Jaycar-Electronics/Portable-Digital-Compass/compass/startup_bitmap.h

#ifndef __COMPASS_STARTUP_BMP_H__
#define __COMPASS_STARTUP_BMP_H__

static const unsigned char PROGMEM compass_startup_bmp[] = {
0x00, 0x00, 0x00, 0x00, 0x00, 0x00, 0x00, 0x00, 0x00, 0x00, 0x00, 0x00, 0x00, 0x00, 0x00, 0x00,
0x00, 0x00, 0x00, 0x00, 0x00, 0x00, 0x00, 0x00, 0x07, 0x00, 0x00, 0x00, 0x00, 0x00, 0x00, 0x00,
0x00, 0x04, 0x80, 0x00, 0x00, 0x00, 0x00, 0x00, 0x08, 0xc0, 0x00, 0x00, 0x00, 0x00, 0x00, 0x00,
0x00, 0x06, 0x80, 0x00, 0x00, 0x00, 0x00, 0x00, 0x10, 0x40, 0x00, 0x00, 0x00, 0x00, 0x00, 0x00,
0x00, 0x05, 0x80, 0x00, 0x00, 0x00, 0x00, 0x00, 0x20, 0x00, 0x00, 0x00, 0x00, 0x00, 0x00, 0x00,
0x00, 0x04, 0x80, 0x00, 0x00, 0x00, 0x00, 0x00, 0x20, 0x03, 0xc5, 0xde, 0x5c, 0x3c, 0x3c, 0xf0,
0x00, 0x00, 0x00, 0x00, 0x00, 0x00, 0x00, 0x00, 0x20, 0x04, 0x26, 0x22, 0x62, 0x42, 0x45, 0x10,
0x00, 0x00, 0x60, 0x00, 0x00, 0x00, 0x00, 0x00, 0x20, 0x04, 0x24, 0x22, 0x42, 0x02, 0x41, 0x00,
0x00, 0x00, 0x7c, 0x00, 0x00, 0x00, 0x00, 0x00, 0x20, 0x04, 0x24, 0x22, 0x42, 0x0e, 0x61, 0x80,
0x00, 0x00, 0x33, 0x00, 0x00, 0x00, 0x00, 0x00, 0x20, 0x04, 0x24, 0x22, 0x42, 0x32, 0x1c, 0x70,
0x00, 0x00, 0x28, 0xe0, 0x00, 0x00, 0x00, 0x00, 0x20, 0x24, 0x24, 0x22, 0x42, 0x42, 0x04, 0x10,
0x00, 0x00, 0x24, 0x18, 0x00, 0x00, 0x00, 0x00, 0x10, 0x44, 0x24, 0x22, 0x42, 0x42, 0x45, 0x10,
0x00, 0x00, 0x12, 0x0c, 0x00, 0x00, 0x00, 0x00, 0x18, 0xc6, 0x24, 0x22, 0x62, 0x46, 0x45, 0x10,
0x00, 0x00, 0x11, 0x14, 0x00, 0x00, 0x00, 0x00, 0x07, 0x03, 0xc4, 0x22, 0x5c, 0x3a, 0x38, 0xe0,
0x00, 0x00, 0x08, 0xe2, 0x00, 0x00, 0x00, 0x00, 0x00, 0x00, 0x00, 0x00, 0x40, 0x00, 0x00, 0x00,
0x00, 0x00, 0x08, 0xa2, 0x00, 0x00, 0x00, 0x00, 0x00, 0x00, 0x00, 0x00, 0x40, 0x00, 0x00, 0x00,
0x00, 0x00, 0x08, 0xe2, 0x00, 0x00, 0x00, 0x00, 0x00, 0x00, 0x00, 0x00, 0x40, 0x00, 0x00, 0x00,
0x00, 0x00, 0x05, 0x11, 0x00, 0x00, 0x00, 0x00, 0x00, 0x00, 0x00, 0x00, 0x00, 0x00, 0x00, 0x00,
0x00, 0x00, 0x06, 0x09, 0x00, 0x00, 0x00, 0x00, 0x00, 0x00, 0x00, 0x00, 0x00, 0x00, 0x00, 0x00,
0x00, 0x00, 0x03, 0x04, 0x80, 0x00, 0x00, 0x00, 0x00, 0x00, 0x00, 0x00, 0x00, 0x00, 0x00, 0x00,
0x00, 0x00, 0x00, 0xe2, 0x80, 0x00, 0x00, 0x00, 0x00, 0x00, 0x00, 0x00, 0x00, 0x00, 0x00, 0x00,
0x00, 0x00, 0x00, 0x19, 0x80, 0x00, 0x48, 0x00, 0x10, 0x00, 0x09, 0x00, 0x12, 0x08, 0x20, 0x08,
0x00, 0x00, 0x00, 0x07, 0xc0, 0x00, 0x48, 0x00, 0x10, 0x00, 0x09, 0x00, 0x12, 0x08, 0x20, 0x08,
0x00, 0x00, 0x00, 0x00, 0xc0, 0x00, 0x49, 0xce, 0x75, 0xe7, 0x0d, 0x33, 0xbb, 0x89, 0x26, 0xdc,
0x00, 0x00, 0x00, 0x00, 0x20, 0x00, 0x7a, 0x42, 0x95, 0x29, 0x0d, 0x4a, 0x12, 0x85, 0x4a, 0x88,
0x00, 0x00, 0x00, 0x00, 0x00, 0x00, 0x4b, 0xce, 0x95, 0x29, 0x0b, 0x4a, 0x12, 0x86, 0xce, 0xc8,
0x00, 0x00, 0x00, 0x00, 0x1e, 0x00, 0x4a, 0x12, 0x95, 0x29, 0x09, 0x4a, 0x12, 0x82, 0x88, 0x48,
0x00, 0x00, 0x00, 0x00, 0x10, 0x00, 0x49, 0xce, 0x75, 0x27, 0x09, 0x32, 0x12, 0x82, 0x86, 0xc8,
0x00, 0x00, 0x00, 0x00, 0x0c, 0x00, 0x00, 0x00, 0x00, 0x01, 0x00, 0x00, 0x00, 0x00, 0x00, 0x00,
0x00, 0x00, 0x00, 0x00, 0x02, 0x00, 0x00, 0x00, 0x00, 0x07, 0x00, 0x00, 0x00, 0x00, 0x00, 0x00,
0x00, 0x00, 0x00, 0x00, 0x1e, 0x00, 0x00, 0x00, 0x00, 0x00, 0x00, 0x00, 0x00, 0x00, 0x00, 0x00,
0x00, 0x00, 0x00, 0x00, 0x00, 0x00, 0x00, 0x00, 0x00, 0x00, 0x00, 0x00, 0x00, 0x00, 0x00, 0x00
};

// you can generate a similar bitmap of side 128x32 and display it here.
// in gimp, you can export as xbm, or use an online arduino bitmap converter.
#endif
